miguel-pramos/projeto-bixo-grupo4/README.md

# projeto-bixo-grupo4
Repositório com as entregas do projeto bixo 2026 do grupo 4
