miguel-pramos/projeto-bixo-grupo4/Eletrônica e Potência/Carrinho.drawio.png

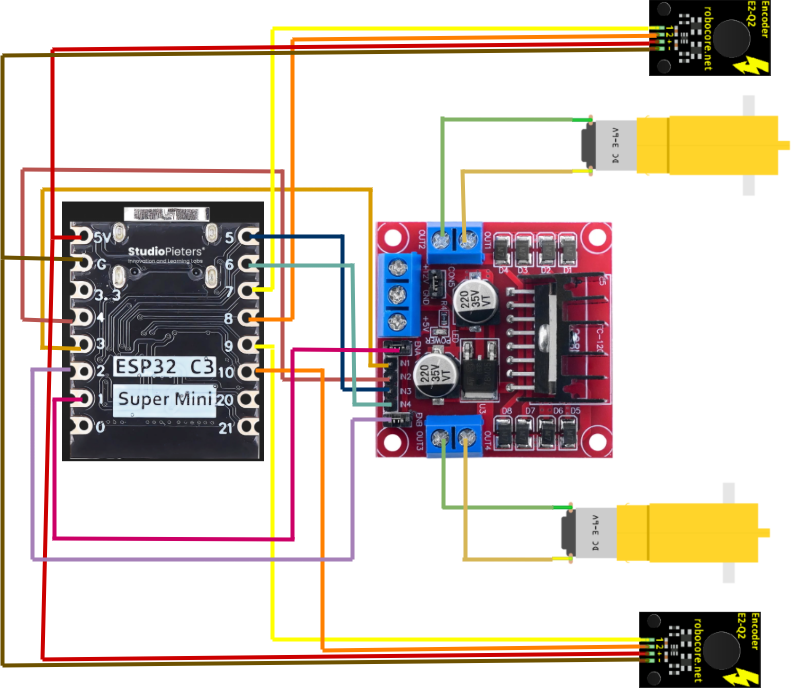
Eletrônica e Potência/Carrinho.drawio.png
