miguel-pramos/projeto-bixo-grupo4/Estrutura e Mecânica/Chassi Grupo4.stl

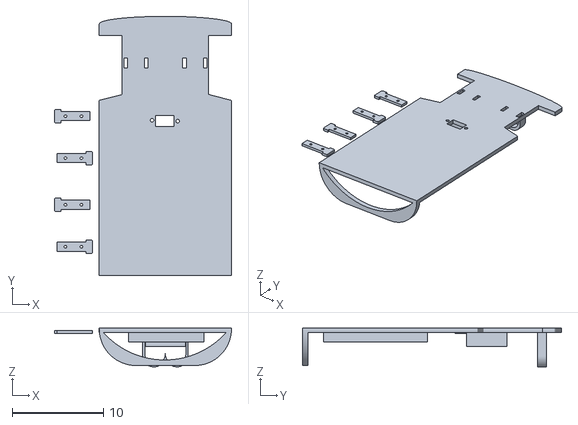
[picture p4: CAD file, 2026-06-22]
Estrutura e Mecânica/Chassi Grupo4.stl
19.4 x 28.4 x 4.25
