miguel-pramos/projeto-bixo-grupo4/Eletrônica e Potência/include/pinos.h

// aqui vamos definir os pinos para que sejam lidos com melhor semântica

// Analógicos
#define ENA 1
#define ENB 2
// Digitais
// Motor 1
#define IN1 3
#define IN2 4
// Motor 2
#define IN3 5
#define IN4 6

// Encoder 1
#define CODERA1 7
#define CODERA2 8

// Encoder 2
#define CODERB1 9
#define CODERB2 10
