miguel-pramos/projeto-bixo-grupo4/(commit log)

2026-06-19 Medida certa do interruptor
2026-06-19 Sobre o sensor ultrassônico
2026-06-21 Anotações sobre planos para o posicionamento do sensor ultrassônico e como os motores podem ser fixados ao chassi
2026-06-22 Linha a mais para pontuar a elevação que vai acomodar a placa padrão
2026-06-22 Arquivo certo do chassi
    [Chassi Grupo4.stl]
2026-07-08 config: encoder
2026-07-09 Diagrama de pinagem com pilha
2026-08-21 Leitura do pino B para descobrir se o carrinho o motor está girando no sentido horário ou anti-horário.
2026-09-11 Inserção do PID
